vanarebane/smartknob/electronics/vanarebane_version/view_screen/view_screen.kicad_pcb

## KiCad design electronics/vanarebane_version/view_screen/view_screen.kicad_pcb (2023-05-20)


Parts:
C1: 22uF; C_0805_2012Metric; Digikey 1276-CL21A226MAYNNNECT-ND
C2: 0.1uF; C_0603_1608Metric; Digikey 1276-1935-1-ND
H1: AlignmentHole; AlignmentHole_1.6
J1, J3, J4, J5: Conn_01x04; SolderPads_2mm_4
J2: GC9A01; GC9A01Round1.28; Digikey N/A
Q1: 2N7002; SOT-23; Digikey 2N7002H6327XTSA2CT-ND
R1: 10k; R_0603_1608Metric; Digikey RMCF0603JT10K0CT-ND
R2: 22R; R_0603_1608Metric; Digikey RMCF0603JT22R0CT-ND
R3: 1M; R_0603_1608Metric; Digikey RMCF0603JT1M00CT-ND

Connections:
/BACKLIGHT_EN: J1.3, J4.3, R1.1
/DC: J1.4, J2.7, J4.4
/LEDA: J2.3, R2.2
/LEDK: J2.2, Q1.3 (D)
/MOSI: J2.10, J3.3, J5.3
/SCK: J2.9, J3.2, J5.2
/VDD: C1.1, C2.1, J1.2, J2.4, J4.2, R2.1
/nCS: J2.8, J3.1, J5.1
/nRESET: J2.11, J3.4, J5.4
GND: C1.2, C2.2, J1.1, J2.1, J2.5, J2.6, J2.12, J4.1, Q1.2 (S), R3.2
unnamed: Q1.1 (G), R1.2, R3.1

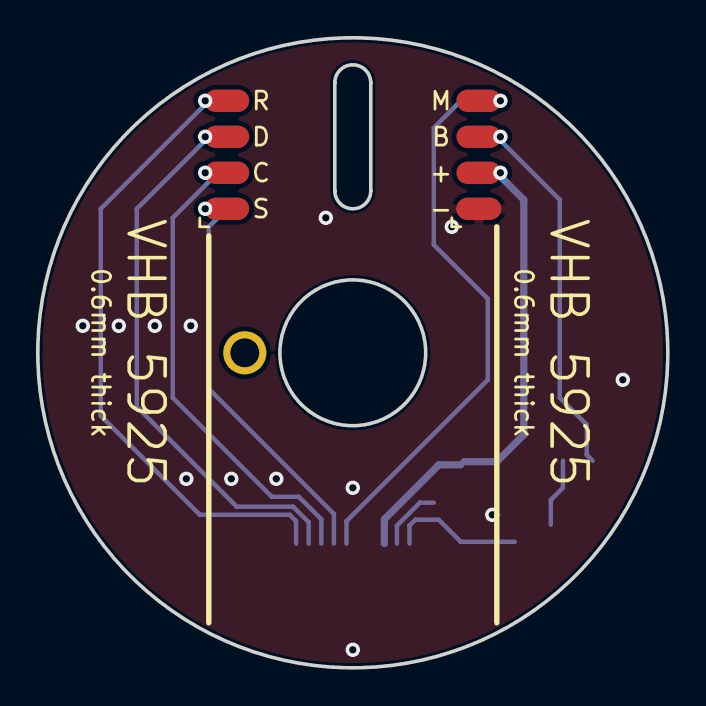
[picture p5: board view_screen.kicad_pcb from above]

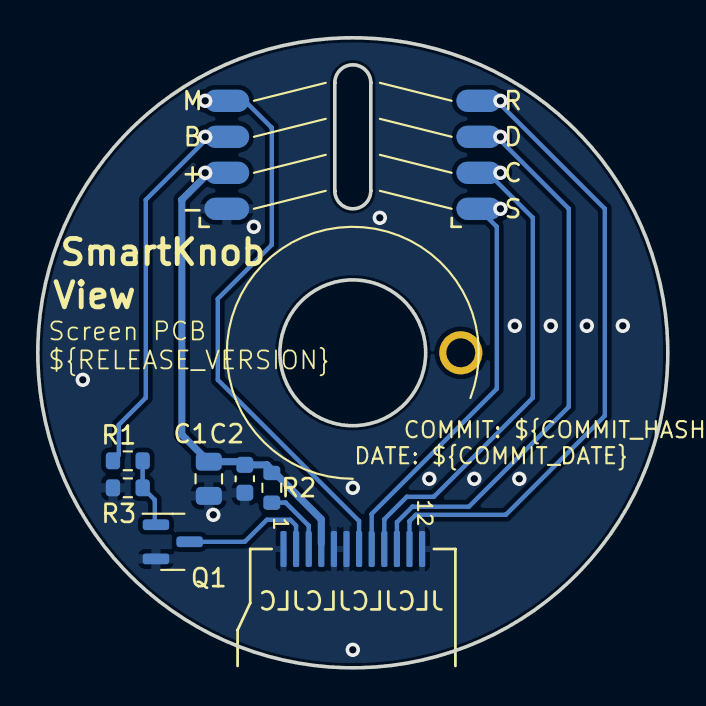
[picture p6: board view_screen.kicad_pcb from below]

Board: 2 copper layers, 35.0 x 35.0 mm, 12 parts (9 on the bottom side), 11 nets.
