vanarebane/smartknob/firmware/src/network/ble_task.cpp

#if SK_BLE

#include "ble_task.h"

bool deviceConnected = false;

bool ble_quiet_please = false;
bool hasNewInputFromBT = false;
bool newBTInputProcessed = true;
char* newInputFromBT;

class KnobServerCallbacks: public BLEServerCallbacks {

    void onConnect(BLEServer* pServer) {
        deviceConnected = true;
    };

    void onDisconnect(BLEServer* pServer) {
        deviceConnected = false;
    }
};

class KnobCharacteristicCallBack : public BLECharacteristicCallbacks{
public:
    //This method not called
    void onWrite(BLECharacteristic *pCharacteristic) override{
        ble_quiet_please = true;
        // std::string xcc = pCharacteristic->getValue();
        // // uint8_t* rxValue = pCharacteristic->getData();
        // Serial.print("value received = ");
        // Serial.println((char*)&xcc);

        newInputFromBT = reinterpret_cast<char*>(pCharacteristic->getData());
        
        // char buf_[256];
        // snprintf(buf_, sizeof(buf_), "value received from BT = %s", val);
        // log(val);

        log_i("data is received");

        // delay(50);
        hasNewInputFromBT = true;
        newBTInputProcessed = false;
        // delay(50);
        ble_quiet_please = false;
    }
};

BLETask::BLETask(const uint8_t task_core) : Task("BLE", 3000, 1, task_core) {
    queue_ = xQueueCreate(5, sizeof(Message));
    assert(queue_ != NULL);
    
    knob_state_queue_ = xQueueCreate(1, sizeof(PB_SmartKnobState));
    assert(knob_state_queue_ != NULL);

    mutex_ = xSemaphoreCreateMutex();
    assert(mutex_ != NULL);
}

BLETask::~BLETask() {
    vQueueDelete(knob_state_queue_);
    vSemaphoreDelete(mutex_);
}

void BLETask::run() {
     
    // See the following for generating UUIDs:
    // https://www.uuidgenerator.net/

    // #define SERVICE_UUID        "4fafc201-1fb5-459e-8fcc-c5c9c331914b"
    // #define CHARACTERISTIC_UUID "beb5483e-36e1-4688-b7f5-ea07361b26a8"
    // #define SERVICE_UUID        "00001235-0000-1000-8000-00805f9b34fb"
    // #define CHARACTERISTIC_UUID   "00004568-0000-1000-8000-00805f9b34fb"
    
    #define SERVICE_UUID           "00000001-0000-1000-8000-00805f9b34fb" // UART service UUID
    #define CHARACTERISTIC_UUID_RX "6E400002-B5A3-F393-E0A9-E50E24DCCA9E" // Writes
    #define CHARACTERISTIC_UUID_TX "6E400003-B5A3-F393-E0A9-E50E24DCCA9E" // Notifications

    // Create the BLE Device
    BLEDevice::init("SmartKnob_0123");

    // Create the BLE Server
    pServer = BLEDevice::createServer();
    pServer->setCallbacks(new KnobServerCallbacks());
    

    // Create the BLE Service
    BLEService *pService = pServer->createService(SERVICE_UUID);


    // Create TX BLE Characteristic
    pTxCharacteristic = pService->createCharacteristic(
        CHARACTERISTIC_UUID_TX,
        BLECharacteristic::PROPERTY_NOTIFY
    );
    pTxCharacteristic->addDescriptor(new BLE2902());


    // Create RX BLE Characteristic
    BLECharacteristic * pRxCharacteristic = pService->createCharacteristic(
        CHARACTERISTIC_UUID_RX,
        BLECharacteristic::PROPERTY_WRITE
    );
    pRxCharacteristic->setCallbacks(new KnobCharacteristicCallBack());


    // Start the service
    pService->start();
        
    // Start advertising
    pServer->getAdvertising()->start();

    // // Start advertising
    // BLEAdvertising *pAdvertising = BLEDevice::getAdvertising();
    // pAdvertising->addServiceUUID(SERVICE_UUID);
    // pAdvertising->setScanResponse(true);
    // pAdvertising->setMinPreferred(0x06);  // functions that help with iPhone connections issue
    // pAdvertising->setMinPreferred(0x12);
    // BLEDevice::startAdvertising();

    PB_SmartKnobState state;

    while (1) {

        if (deviceConnected && !ble_quiet_please) { 
                   
            // Old method here, skip everything if no update from knob
            if (xQueueReceive(knob_state_queue_, &state, portMAX_DELAY) == pdFALSE) {
                continue;
            }

            if(button_state_old != button_state_){
                button_state_old = button_state_;
                sendNotify(1, button_state_old);
            }

            if(press_value_unit_old != press_value_unit_){
                press_value_unit_old = press_value_unit_;
                sendNotify(2, press_value_unit_old);
            }

            if (press_state_old != press_state_){
                press_state_old = press_state_;
                sendNotify(3, press_state_old);
            }

            if (current_position != state.current_position){
                current_position = state.current_position;
                sendNotify(4, current_position);
            }

            if (num_positions != state.config.num_positions){
                num_positions = state.config.num_positions;
                sendNotify(5, num_positions);
            }

            if (lux_value_old != lux_value_){
                lux_value_old = lux_value_;
                sendNotify(6, lux_value_old);
            }

            subpos = floorf( state.sub_position_unit * 100) / 100;
            if (trunc(20. * sub_positions) != trunc(20. * subpos)){
            // if (sub_positions != subpos){
                sub_positions = subpos;
                sendNotify(7, sub_positions);
            }

            // Pressure on the click sensor, quantized to 1% steps
            if ((uint32_t)(pressure_unit_ * 100) != (uint32_t)(pressure_unit_old_ * 100)){
                pressure_unit_old_ = pressure_unit_;
                float pressure_pct = pressure_unit_ * 100;
                sendNotify(8, pressure_pct);
            }

            if (actuation_ != actuation_old_){
                actuation_old_ = actuation_;
                float actuation_pct = actuation_ * 100;
                sendNotify(9, actuation_pct);
            }

        }

        // disconnecting
        if (!deviceConnected && oldDeviceConnected) {
            delay(500); // give the bluetooth stack the chance to get things ready
            pServer->startAdvertising(); // restart advertising
            log("BLE start advertising");
            oldDeviceConnected = deviceConnected;
        }
        // connecting
        if (deviceConnected && !oldDeviceConnected) {
            oldDeviceConnected = deviceConnected;
            // Report the current actuation point so the client's UI can sync.
            // Wait for the client to subscribe to notifications first.
            delay(1000);
            float actuation_pct = actuation_ * 100;
            sendNotify(9, actuation_pct);
            sendDiagText();
        }


        // // Check queue for pending requests from other tasks
        // Message message;
        // if (xQueueReceive(queue_, &message, 0) == pdTRUE) {
        //     switch (message.message_type) {
        //         case MessageType::READ:{
        //             break;
        //         }
        //         case MessageType::WRITE: {
        //             break;
        //         }
        //         case MessageType::NOTIFY: {
        //             break;
        //         }
        //         case MessageType::INDICATE: {
        //             break;
        //         }
        //     }
        // }

    }

}

void BLETask::sendNotify(int key, bool data){
    uint8_t temp[2];
	temp[0] = key;
    if(data) temp[1] = 1;
    else temp[1] = 0;
    pTxCharacteristic->setValue((uint8_t*)&temp, 2);
    pTxCharacteristic->notify();
    delay(ble_delay); // bluetooth stack will go into congestion, if too many packets are sent, in 6 hours test i was able to go as low as 3ms
}
void BLETask::sendNotify(int key, uint32_t data32){
    uint8_t temp[5];
	temp[0] = key;
	temp[1] = data32;
	temp[2] = data32 >> 8;
	temp[3] = data32 >> 16;
	temp[4] = data32 >> 24;
    pTxCharacteristic->setValue((uint8_t*)&temp,5);
    pTxCharacteristic->notify();
    delay(ble_delay); // bluetooth stack will go into congestion, if too many packets are sent, in 6 hours test i was able to go as low as 3ms
}
void BLETask::sendNotify(int key, float& dataf){
    uint8_t temp[5];
    uint32_t data = static_cast<uint32_t>(dataf * 100);
	temp[0] = key;
	temp[1] = data;
	temp[2] = data >> 8;
	temp[3] = data >> 16;
	temp[4] = data >> 24;
    pTxCharacteristic->setValue((uint8_t*)&temp,5);
    pTxCharacteristic->notify();
    delay(ble_delay); // bluetooth stack will go into congestion, if too many packets are sent, in 6 hours test i was able to go as low as 3ms
}

void BLETask::updateScale(int32_t new_press_value_unit){
    press_value_unit_ = new_press_value_unit;
}

void BLETask::updateScale(bool new_press_state){
    press_state_ = new_press_state;
}

void BLETask::updateLux(float new_lux_value){
    lux_value_ = new_lux_value;
}

void BLETask::updatePressure(float pressure_unit){
    pressure_unit_ = pressure_unit;
}

void BLETask::updateActuation(float actuation_unit){
    actuation_ = actuation_unit;
}

void BLETask::setDiagText(const char* text){
    strncpy(diag_text_, text, sizeof(diag_text_) - 1);
    diag_text_[sizeof(diag_text_) - 1] = '\0';
}

// Key 10 carries text in <=19-byte chunks; a bare key byte marks end of message
void BLETask::sendDiagText(){
    size_t len = strlen(diag_text_);
    if (len == 0) return;
    uint8_t pkt[20];
    for (size_t off = 0; off < len; off += 19) {
        size_t chunk = len - off > 19 ? 19 : len - off;
        pkt[0] = 10;
        memcpy(pkt + 1, diag_text_ + off, chunk);
        pTxCharacteristic->setValue(pkt, chunk + 1);
        pTxCharacteristic->notify();
        delay(ble_delay);
    }
    pkt[0] = 10;
    pTxCharacteristic->setValue(pkt, 1);
    pTxCharacteristic->notify();
    delay(ble_delay);
}

void BLETask::updateButton(bool new_button_state){
    button_state_ = new_button_state;
}


bool BLETask::hasInputFromBT(){

    if(hasNewInputFromBT){
        if(newBTInputProcessed){
            return true;
        }
        else{
            log("Received from BT: ");
            log(newInputFromBT);

            // already set to true
            newBTInputProcessed = true;

            if (std::strncmp(newInputFromBT, "SP+", 3) == 0) {
                // Create the struct instance
                PB_SmartKnobConfig profile;

                // Parse the input and populate the struct
                if (parseInputProfile(newInputFromBT, profile)) {
                    new_motor_profile = profile;
                    hasNewMotorProfile_ = true;
                    return true;
                } else {
                    log("Invalid input SP");
                    hasNewInputFromBT = false;
                    hasNewMotorProfile_ = false;
                    return false;
                }
            }
            else if (std::strncmp(newInputFromBT, "AP+", 3) == 0) {
                float value = std::atof(newInputFromBT + 3);
                if (value >= 0.05f && value <= 1.0f) {
                    new_actuation_ = value;
                    hasNewActuation_ = true;
                    return true;
                } else {
                    log("Invalid input AP");
                    hasNewInputFromBT = false;
                    hasNewActuation_ = false;
                    return false;
                }
            }
            else if (std::strncmp(newInputFromBT, "CAL", 3) == 0) {
                log("Calibration requested from BT");
                calibrateRequested_ = true;
                hasNewInputFromBT = false;
                return false;
            }
            else if (std::strncmp(newInputFromBT, "OTA", 3) == 0) {
                log("OTA mode requested from BT");
                otaRequested_ = true;
                hasNewInputFromBT = false;
                return false;
            }
            else if (std::strncmp(newInputFromBT, "CM+", 3) == 0) {

                MotorConfig config;

                // Parse the input and populate the struct
                if (parseInputConfig(newInputFromBT, config)) {
                    new_motor_config = config;
                    hasNewMotorConfig_ = true;
                    return true;
                } else {
                    log("Invalid input CF/CM");
                    hasNewInputFromBT = false;
                    hasNewMotorConfig_ = false;
                    return false;
                }
            }
            
 
        }
    }

    else return false;

}
bool BLETask::hasNewMotorProfile(){
    return hasNewMotorProfile_;
}
bool BLETask::otaRequested(){
    return otaRequested_;
}
// One-shot: clears on read so calibration runs once per request
bool BLETask::calibrateRequested(){
    if (calibrateRequested_) {
        calibrateRequested_ = false;
        return true;
    }
    return false;
}
bool BLETask::hasNewActuationPoint(){
    return hasNewActuation_;
}
float BLETask::getActuationPoint(){
    hasNewActuation_ = false;
    hasNewInputFromBT = false;
    return new_actuation_;
}
bool BLETask::hasNewMotorConfig(){
    return hasNewMotorConfig_;
}

PB_SmartKnobConfig BLETask::getMotorProfile(){
    hasNewInputFromBT = false;
    return new_motor_profile;
}

MotorConfig BLETask::getMotorConfig(){
    hasNewInputFromBT = false;
    return new_motor_config;
}

// Function to parse the input string and populate the struct
bool BLETask::parseInputProfile(const char* input, PB_SmartKnobConfig& data) {
    // // Check for "SP+" prefix
    if (std::strncmp(input, "SP+", 3) != 0) {
        return false;
    }

    // Extract the relevant part after "SP+"
    const char* dataString = input + 3;

    // // Split the string by commas
    std::vector<const char*> tokens;
    char* mutableDataString = new char[std::strlen(dataString) + 1];
    std::strcpy(mutableDataString, dataString);

    char* token = std::strtok(mutableDataString, ",");
    while (token != nullptr) {
        tokens.push_back(token);
        token = std::strtok(nullptr, ",");
    }

    // Check if we have the expected number of values
    if (tokens.size() != 7) {
        delete[] mutableDataString;
        return false;
    }

    // int32_t num_positions;
    // int32_t position;
    // float position_width_radians; // remember  * PI / 180
    // float detent_strength_unit;
    // float endstop_strength_unit;
    // float snap_point;
    // char text[51];
    
    // Convert and assign the values to the struct
    try {
        data.num_positions = std::atoi(tokens[0]);
        data.position = std::atoi(tokens[1]);
        data.position_width_radians = std::atof(tokens[2]) * PI / 180;
        data.detent_strength_unit = std::atof(tokens[3]);
        data.endstop_strength_unit = std::atof(tokens[4]);
        data.snap_point = std::atof(tokens[5]);
        std::strncpy(data.text, tokens[6], sizeof(data.text) - 1);
        data.text[sizeof(data.text) - 1] = '\0'; // Ensure null termination
    } catch (...) {
        delete[] mutableDataString;
        return false;
    }

    delete[] mutableDataString;
    return true;
}
// Function to parse the input string and populate the struct
bool BLETask::parseInputConfig(const char* input, MotorConfig& data) {
    // Check for correct prefix
    if (std::strncmp(input, "CM+", 3) != 0) {
        return false;
    }

    // Extract the relevant part after "SP+"
    const char* dataString = input + 3;

    // // Split the string by commas
    std::vector<const char*> tokens;
    char* mutableDataString = new char[std::strlen(dataString) + 1];
    std::strcpy(mutableDataString, dataString);

    char* token = std::strtok(mutableDataString, ",");
    while (token != nullptr) {
        tokens.push_back(token);
        token = std::strtok(nullptr, ",");
    }

    // float zeroElecricalOffset;
    // Direction focDirection;
    // int scaleTop;
    // int scaleLow;

    // Check if we have the expected number of values
    if (tokens.size() < 2) {
        delete[] mutableDataString;
        return false;
    }
    
    // Convert and assign the values to the struct
    try {
        data.zeroElecricalOffset = std::atof(tokens[0]);
        data.focDirection = std::atoi(tokens[1]);
    } catch (...) {
        delete[] mutableDataString;
        return false;
    }
    
    if (tokens.size() == 4) {
        try {
            data.scaleTop = std::atof(tokens[2]);
            data.scaleLow = std::atof(tokens[3]);
        } catch (...) {
            delete[] mutableDataString;
            return false;
        }
    }

    delete[] mutableDataString;
    return true;
}

void BLETask::addListener(QueueHandle_t queue) {
    listeners_.push_back(queue);
}

void BLETask::publish(const PB_SmartKnobState& state) {
    for (auto listener : listeners_) {
        xQueueOverwrite(listener, &state);
    }
}

QueueHandle_t BLETask::getKnobStateQueue() {
    return knob_state_queue_;
}


void BLETask::setLogger(Logger* logger) {
    logger_ = logger;
}

void BLETask::log(const char* msg) {
    if (logger_ != nullptr) {
        logger_->log(msg);
    }
}

#else

class BLETask {};

#endif
