vanarebane/smartknob/(commit log)

2022-11-30 change USB tpye-c port
    [view_base.kicad_pcb]
2023-01-11 Added proximity and accelerator sensor
    [view_base.kicad_sch]
2025-02-13 move schematic folder
    [BM28B0.6-24DSBreakout.kicad_pcb, BM28B0.6-24DSBreakout.sch, LevelShifterBreakout.kicad_pcb, LevelShifterBreakout.sch, view_bas_orig.kicad_sch, view_base.kicad_pcb, view_base.kicad_sch, view_screen.kicad_pcb]
2025-02-25 reverted back to old BLE lib - works well with only one characteristic
    [ble_task.cpp, ble_task.h]
2025-02-28 BLE some values correct / button added: works / started with onWrite()
    [ble_task.cpp, ble_task.h, interface_task.cpp]
2025-03-01 BLE almost works - some JS errors in browser
    [ble_task.cpp, ble_task.h, interface_task.cpp]
2025-03-02 BLE fixed - Motor 98%
    [ble_task.h, motor_task.cpp]
2025-03-08 Sub value and Motor config implemented
    Needs firmware update
